meffie/6502/images/6502-memory-map.png

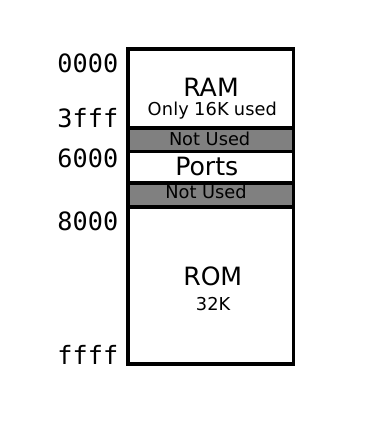
images/6502-memory-map.png
