meffie/6502/kicad/mm6502.kicad_pcb

## KiCad design electronics/microgram_scale.sch


Parts:
D1: SFH4356P; LED_D3.0mm_IRBlack
MES1: Galvanometer
Q1: Q_Photo_NPN
R1: 20k
R2: 680
R3: R
RV1, RV3: R_POT
RV2, RV4: 100k
TP1: To Multimeter/Oscilloscope/µCU analog read
U1: TL072

Connections:
+9V: D1.2 (A), RV1.3, RV3.3
GND: MES1.1 (-), Q1.2 (E), R3.2, RV1.1, RV3.1
unnamed: D1.1 (K), R3.1
unnamed: MES1.2 (+), R2.1
unnamed: Q1.1 (C), RV2.2, U1.2 (-)
unnamed: R1.1, R2.2, RV2.3, RV4.2, U1.1
unnamed: R1.2, U1.6 (-)
unnamed: RV1.2, U1.3 (+)
unnamed: RV3.2, U1.5 (+)
unnamed: RV4.3, TP1.1, U1.7
