meffie/6502/(commit log)

2021-12-27 Arduino sketch to trace address and data lines
2021-12-31 Print hello world as a string
2022-01-02 Refactor lcd routines to common file
    Make a mini driver from the ldc routines. Pass the address of the
    string to be printed in the a and x registers as the low and high bytes
    of the address.
2022-07-20 Reverse the address and data pins
    I extended the data and address lines to a forth breadboard.
    Flip the pin assigments so the arduino fits better.
    Also, remove the tick counter reset.
    [trace1.ino]
2022-07-23 arduino: change control pin assignments
2022-07-27 7 segment led demo
2022-07-27 arduino: update output format
2022-07-28 Revert "arduino: update output format"
    This reverts commit d306b39f4b2f8aaecd2310b4eeecceb9269ac2fb.
    [trace1.ino]
2022-08-02 arduino: tweak format
2023-01-19 Add kicad schematic
    [mm6502.kicad_pcb, mm6502.sch]
2023-01-19 Add reset circuit
    [mm6502-reset.sch]
2023-01-19 Multiple sheets
    [mm6502-decode.sch, mm6502-main.sch, mm6502-reset.sch]
2023-01-19 Set reference ids in reset circuit
    [mm6502-reset.sch]
2023-01-19 Add missing data bus link
    [mm6502-main.sch]
2023-01-19 Add schematics to readme
2023-01-24 kicad: Add ACIA
    [mm6502-decode-rev2.sch, mm6502-main-rev2.sch, mm6502-reset-rev2.sch]
2023-06-28 serial: fix control bits
    [trace1.ino]
2023-07-04 Use LSR when printing hex digits
2023-07-17 Timer 2 test
2023-07-23 Update timer2 test
